HeyPCB/iris-brainstem/media/bottom.png

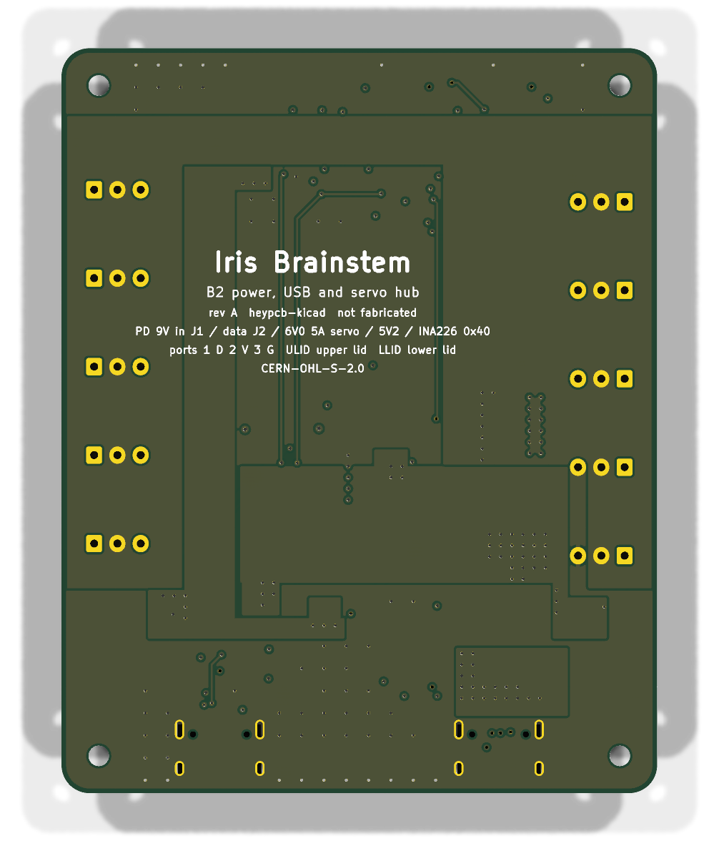
media/bottom.png
