HeyPCB/iris-brainstem/media/top.png

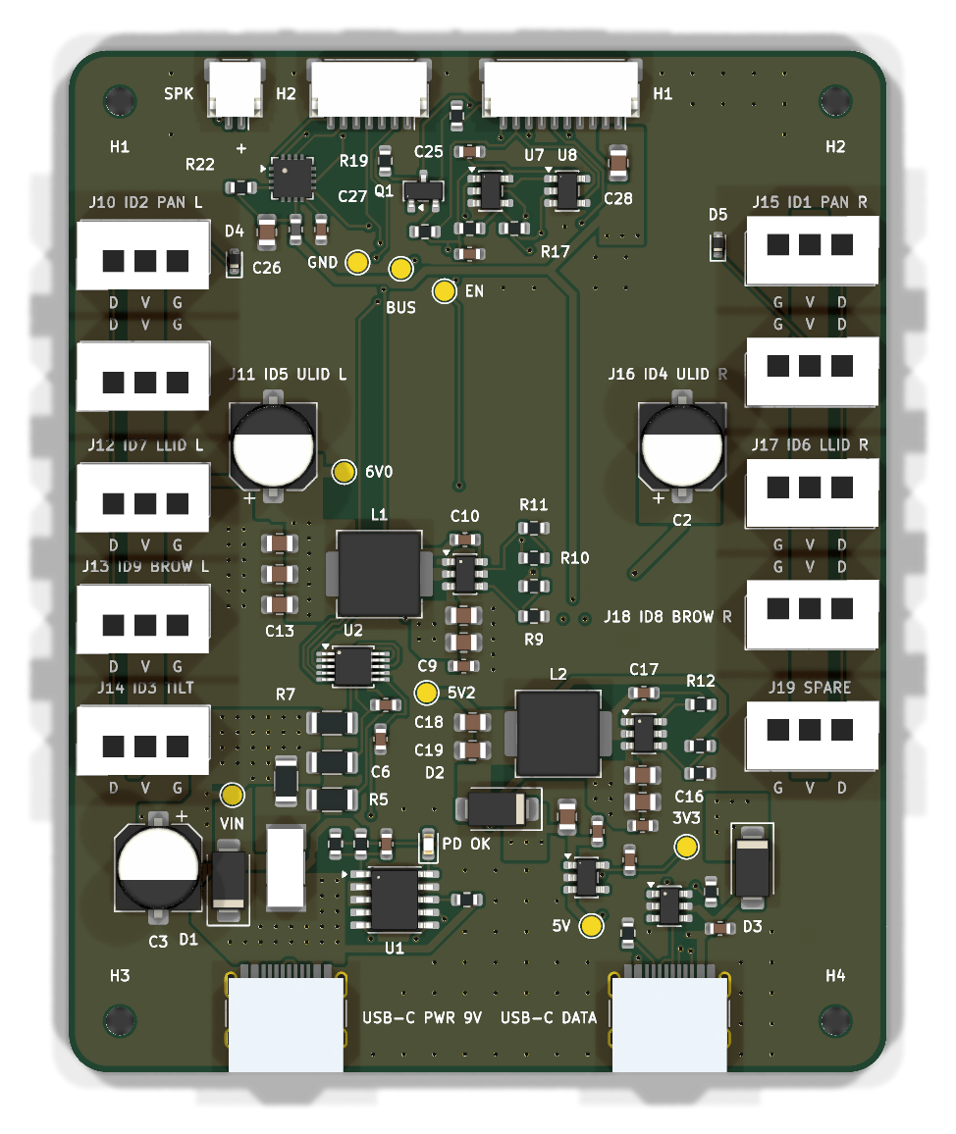
media/top.png
