HeyPCB/iris-brainstem/fab/iris_brainstem_bom.csv

Reference | Value | Footprint | MPN | LCSC | Qty
C1,C2,C3 | 470uF 16V | Capacitor_SMD:CP_Elec_6.3x7.7 | RVT1C471M0607 | C2977552 | 3
C4,C21,C22,C23 | 1uF | Capacitor_SMD:C_0603_1608Metric | CL10A105KB8NNNC | C15849 | 4
C5,C6,C9,C10,C16,C17,C24,C25,C27 | 100nF | Capacitor_SMD:C_0603_1608Metric | CC0603KRX7R9BB104 | C14663 | 9
C7,C8,C14,C15,C26,C28 | 10uF | Capacitor_SMD:C_0805_2012Metric | CL21A106KAYNNNE | C15850 | 6
C11,C12,C13,C18,C19,C20 | 22uF | Capacitor_SMD:C_0805_2012Metric | CL21A226MAQNNNE | C45783 | 6
D1 | SMAJ15A | Diode_SMD:D_SMA | SMAJ15A | C19077535 | 1
D2,D3 | SS34 | Diode_SMD:D_SMA | SS34 | C8678 | 2
D4,D5 | ESD5Z5.0 | Diode_SMD:D_SOD-523 | ESD5Z5.0T1G | C82044 | 2
D6 | Red (PD OK) | LED_SMD:LED_0603_1608Metric | KT-0603R | C2286 | 1
F1 | 5A | Fuse:Fuse_Littelfuse-NANO2-451_453 | 0451005.MRL | C48467 | 1
FB1 | 120R@100MHz | Inductor_SMD:L_0603_1608Metric | BLM18PG121SN1D | C14709 | 1
J1 | USB-C PWR | Connector_USB:USB_C_Receptacle_HRO_TYPE-C-31-M-12 | TYPE-C-31-M-12 | C165948 | 1
J2 | USB-C DATA | Connector_USB:USB_C_Receptacle_HRO_TYPE-C-31-M-12 | TYPE-C-31-M-12 | C165948 | 1
J5 | H1 | Connector_JST:JST_SH_SM10B-SRSS-TB_1x10-1MP_P1.00mm_Horizontal | SM10B-SRSS-TB(LF)(SN) | C160409 | 1
J6 | H2 | Connector_JST:JST_SH_SM07B-SRSS-TB_1x07-1MP_P1.00mm_Horizontal | SM07B-SRSS-TB(LF)(SN) | C160406 | 1
J7 | SPK | Connector_JST:JST_SH_SM02B-SRSS-TB_1x02-1MP_P1.00mm_Horizontal | SM02B-SRSS-TB(LF)(SN) | C160402 | 1
J10,J11,J12,J13,J14,J15,J16,J17,J18,J19 | SERVO | Connector_Molex:Molex_SPOX_5267-03A_1x03_P2.50mm_Vertical | HC-5264-3A | C2845815 | 10
L1 | 3.3uH | Inductor_SMD:L_Changjiang_FXL0630 | FXL0630-3R3-M | C167219 | 1
L2 | 5.6uH | Inductor_SMD:L_Changjiang_FXL0630 | FXL0630-5R6-M | C475914 | 1
Q1 | MMBT3906 | Package_TO_SOT_SMD:SOT-23 | MMBT3906LT1G | C53444 | 1
R1 | 10m | Resistor_SMD:R_1206_3216Metric | FMF06FTHR010-LH | C105362 | 1
R2,R10 | 1k | Resistor_SMD:R_0603_1608Metric | 0603WAF1001T5E | C21190 | 2
R3,R9,R14,R17,R18,R20,R21 | 10k | Resistor_SMD:R_0603_1608Metric | FRC0603F1002TS | C2906982 | 7
R4 | 2.2k | Resistor_SMD:R_0603_1608Metric | 0603WAF2201T5E | C4190 | 1
R5,R6,R7 | 10 | Resistor_SMD:R_1206_3216Metric | 1206W4F100JT5E | C17903 | 3
R8 | 68k | Resistor_SMD:R_0603_1608Metric | 0603WAF6802T5E | C23231 | 1
R11 | 100k | Resistor_SMD:R_0603_1608Metric | 0603WAF1003T5E | C25803 | 1
R12 | 33 | Resistor_SMD:R_0603_1608Metric | 0603WAF330JT5E | C23140 | 1
R13 | 54.9k | Resistor_SMD:R_0603_1608Metric | 0603WAF5492T5E | C23077 | 1
R15,R16 | 5.1k | Resistor_SMD:R_0603_1608Metric | 0603WAF5101T5E | C23186 | 2
R19 | 20k | Resistor_SMD:R_0603_1608Metric | 0603WAF2002T5E | C4184 | 1
R22 | 1M | Resistor_SMD:R_0603_1608Metric | 0603WAF1004T5E | C22935 | 1
U1 | CH224K | Package_SO:SSOP-10-1EP_3.9x4.9mm_P1mm_EP2.1x3.3mm | CH224K | C970725 | 1
U2 | INA226 | Package_SO:TSSOP-10_3x3mm_P0.5mm | INA226AIDGSR | C49851 | 1
U3 | TPS565208 | Package_TO_SOT_SMD:SOT-23-6 | TPS565208DDCR | C2650336 | 1
U4 | TPS56339 | Package_TO_SOT_SMD:SOT-23-6 | TPS56339DDCR | C2071106 | 1
U5 | USBLC6-2SC6 | Package_TO_SOT_SMD:SOT-23-6 | USBLC6-2SC6 | C7519 | 1
U6 | AP2112K-3.3 | Package_TO_SOT_SMD:SOT-23-5 | AP2112K-3.3TRG1 | C51118 | 1
U7 | 74LVC1G126 | Package_TO_SOT_SMD:SOT-23-5 | SN74LVC1G126DBVR | C7834 | 1
U8 | 74LVC1G125 | Package_TO_SOT_SMD:SOT-23-5 | SN74LVC1G125DBVR | C23654 | 1
U9 | MAX98357A | Package_DFN_QFN:TQFN-16-1EP_3x3mm_P0.5mm_EP1.23x1.23mm | MAX98357AETE+T | C910544 | 1
