HeyPCB/iris-brainstem/fab/iris_brainstem.step

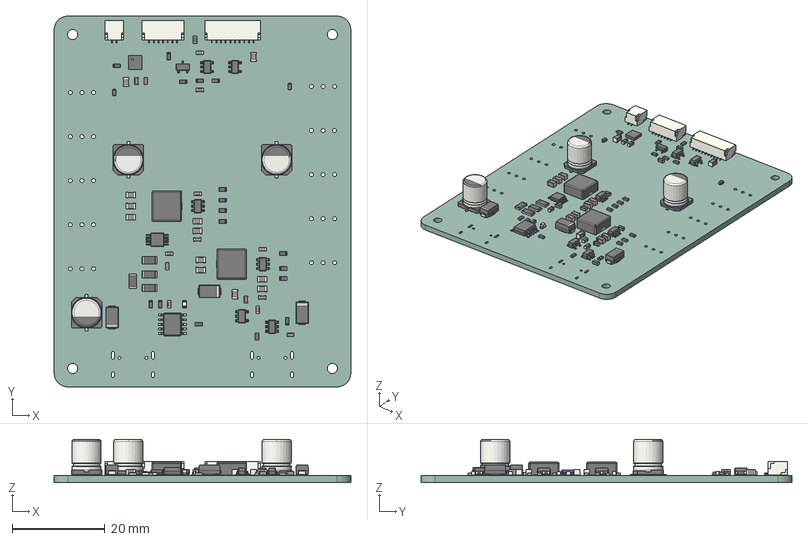
[picture p5: CAD file, 2026-10-03]
fab/iris_brainstem.step
64.0 x 80.0 x 9.29 mm
SSOP-10-1EP_3.9x4.9mm_P1mm_EP2.1x3.3mm
C_0603_1608Metric x 13
R_0603_1608Metric x 18
C_0805_2012Metric x 12
SOT-23-6 x 3
CP_Elec_63x77 x 3
D_SMA x 3
LED_0603_1608Metric
SOT-23-5 x 3
SOT-23
JST_SH_SM02B-SRSS-TB_1x02-1MP_P1.00mm_Horizontal
R_1206_3216Metric x 4
JST_SH_SM07B-SRSS-TB_1x07-1MP_P1.00mm_Horizontal
D_SOD_523 x 2
TQFN_16_1EP_3x3mm_P05mm_EP16x16mm
L_0603_1608Metric
L_Changjiang_FXL0630 x 2
JST_SH_SM10B-SRSS-TB_1x10-1MP_P1.00mm_Horizontal
TSSOP-10_3x3mm_P0.5mm
iris_brainstem_PCB
