HeyPCB/iris-brainstem/fab/iris_brainstem_schematic.pdf

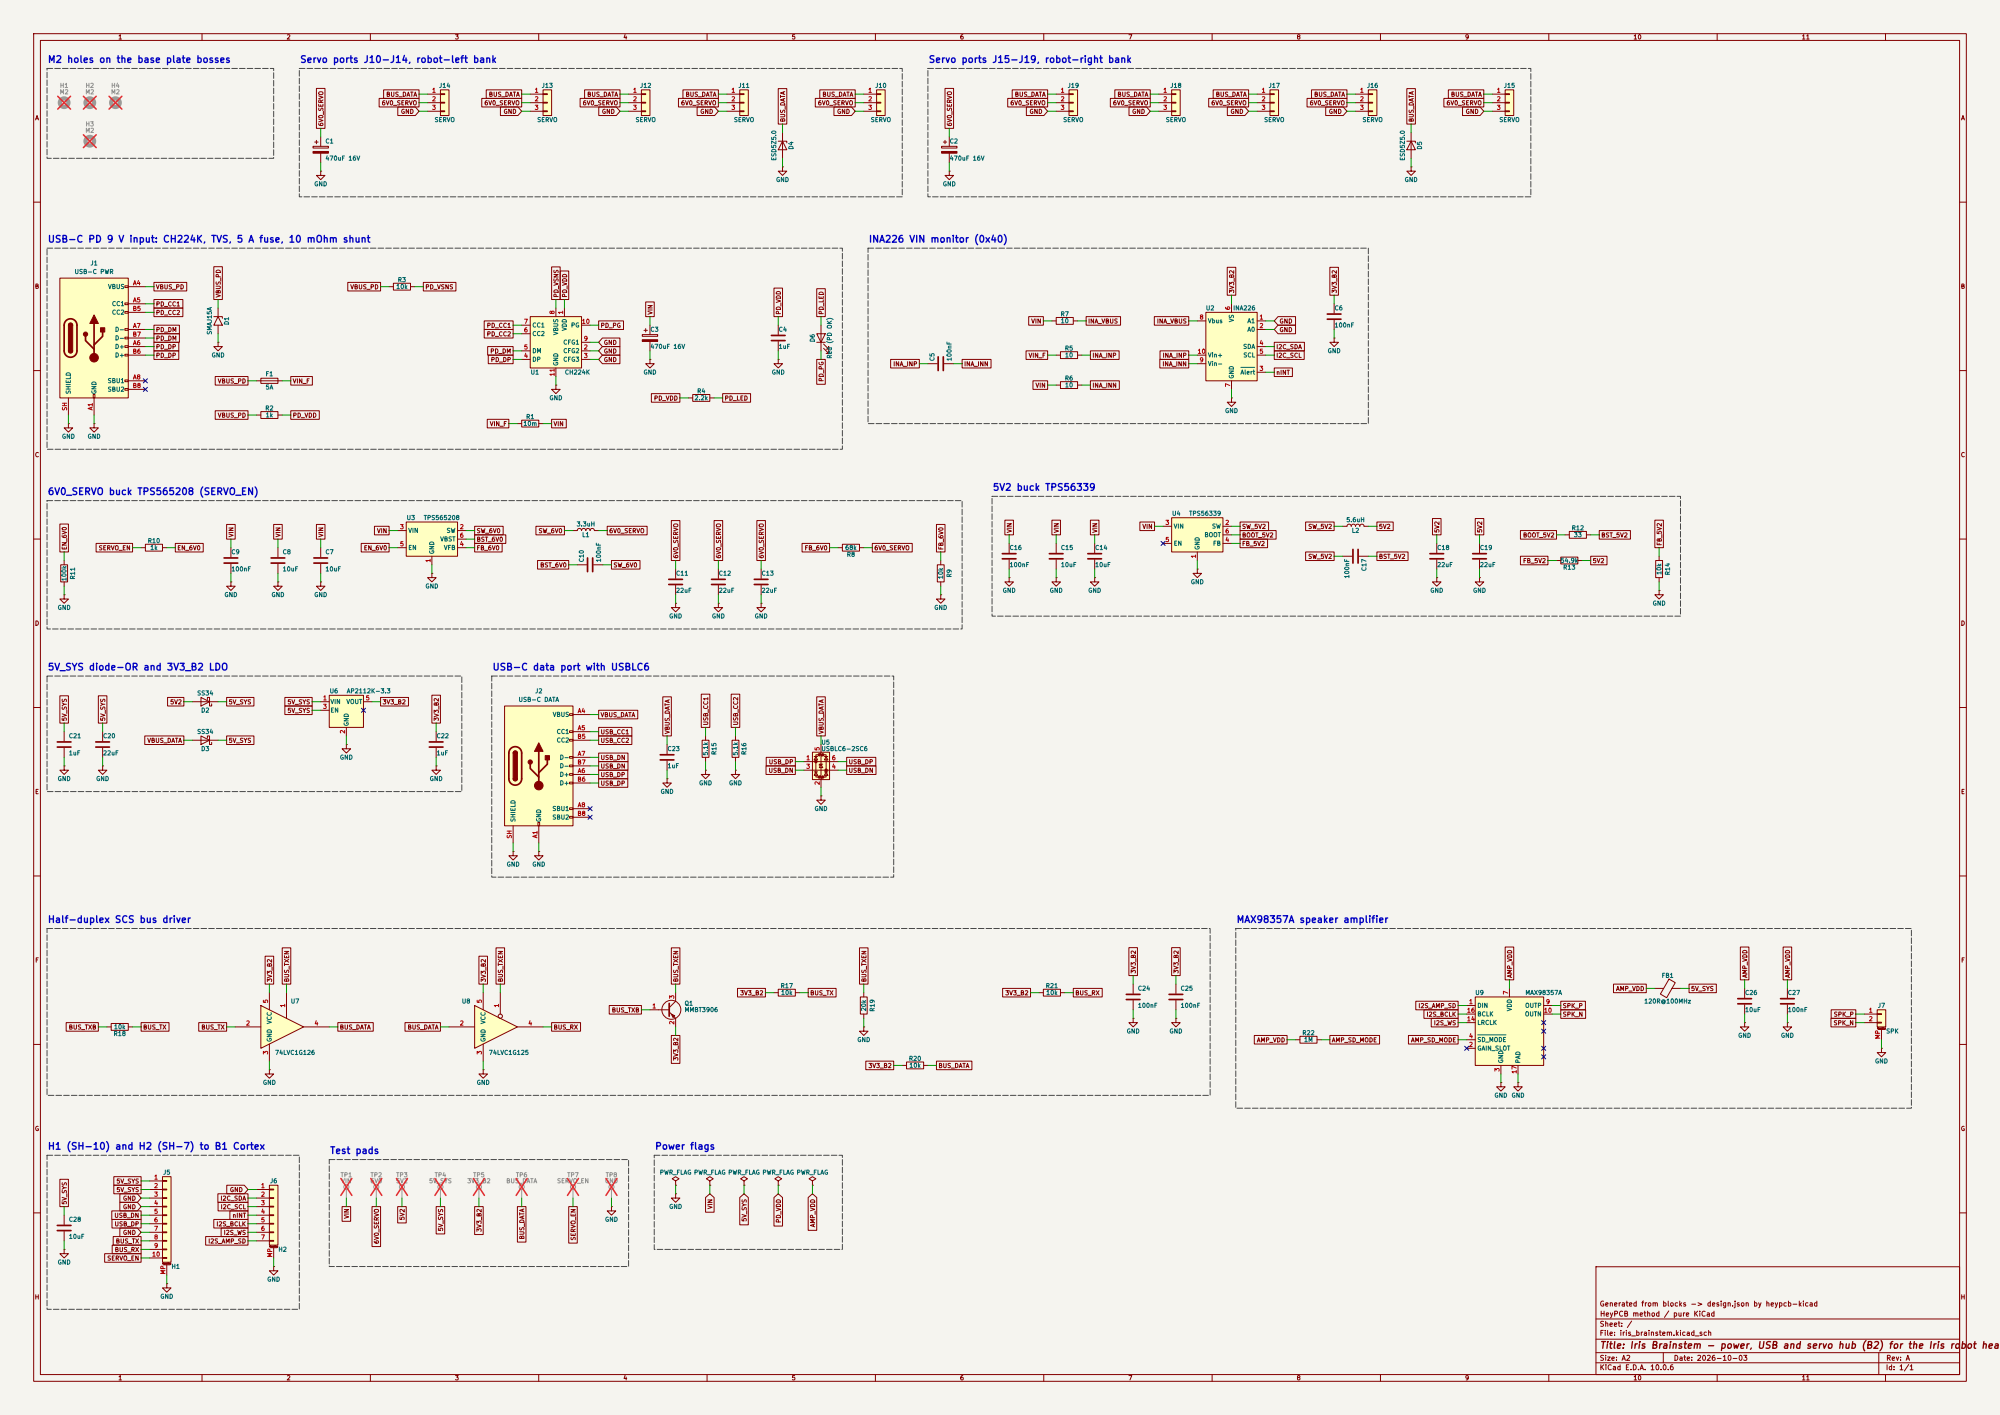
[picture p6: page 1]

M2 holes on the base plate bosses

Servo ports J15-J19, robot-right bank

USB-C PD 9 V input: CH224K, TVS, 5 A fuse, 10 mOhm shunt

5V_SYS diode-OR and 3V3_B2 LDO

USB-C data port with USBLC6

Half-duplex SCS bus driver

H1 (SH-10) and H2 (SH-7) to B1 Cortex

Generated from blocks -> design.json by heypcb-kicad
HeyPCB method / pure KiCad
Sheet: /
File: iris_brainstem.kicad_sch
Title: Iris Brainstem - power, USB and servo hub (B2) for the Iris robot head

Size: A2 | Rev: A
KiCad E.D.A. 10.0.6 | Id: 1/1
