HeyPCB/iris-brainstem/kicad/iris_brainstem.kicad_pcb

## KiCad design kicad/iris_brainstem.kicad_pcb (2026-10-03)

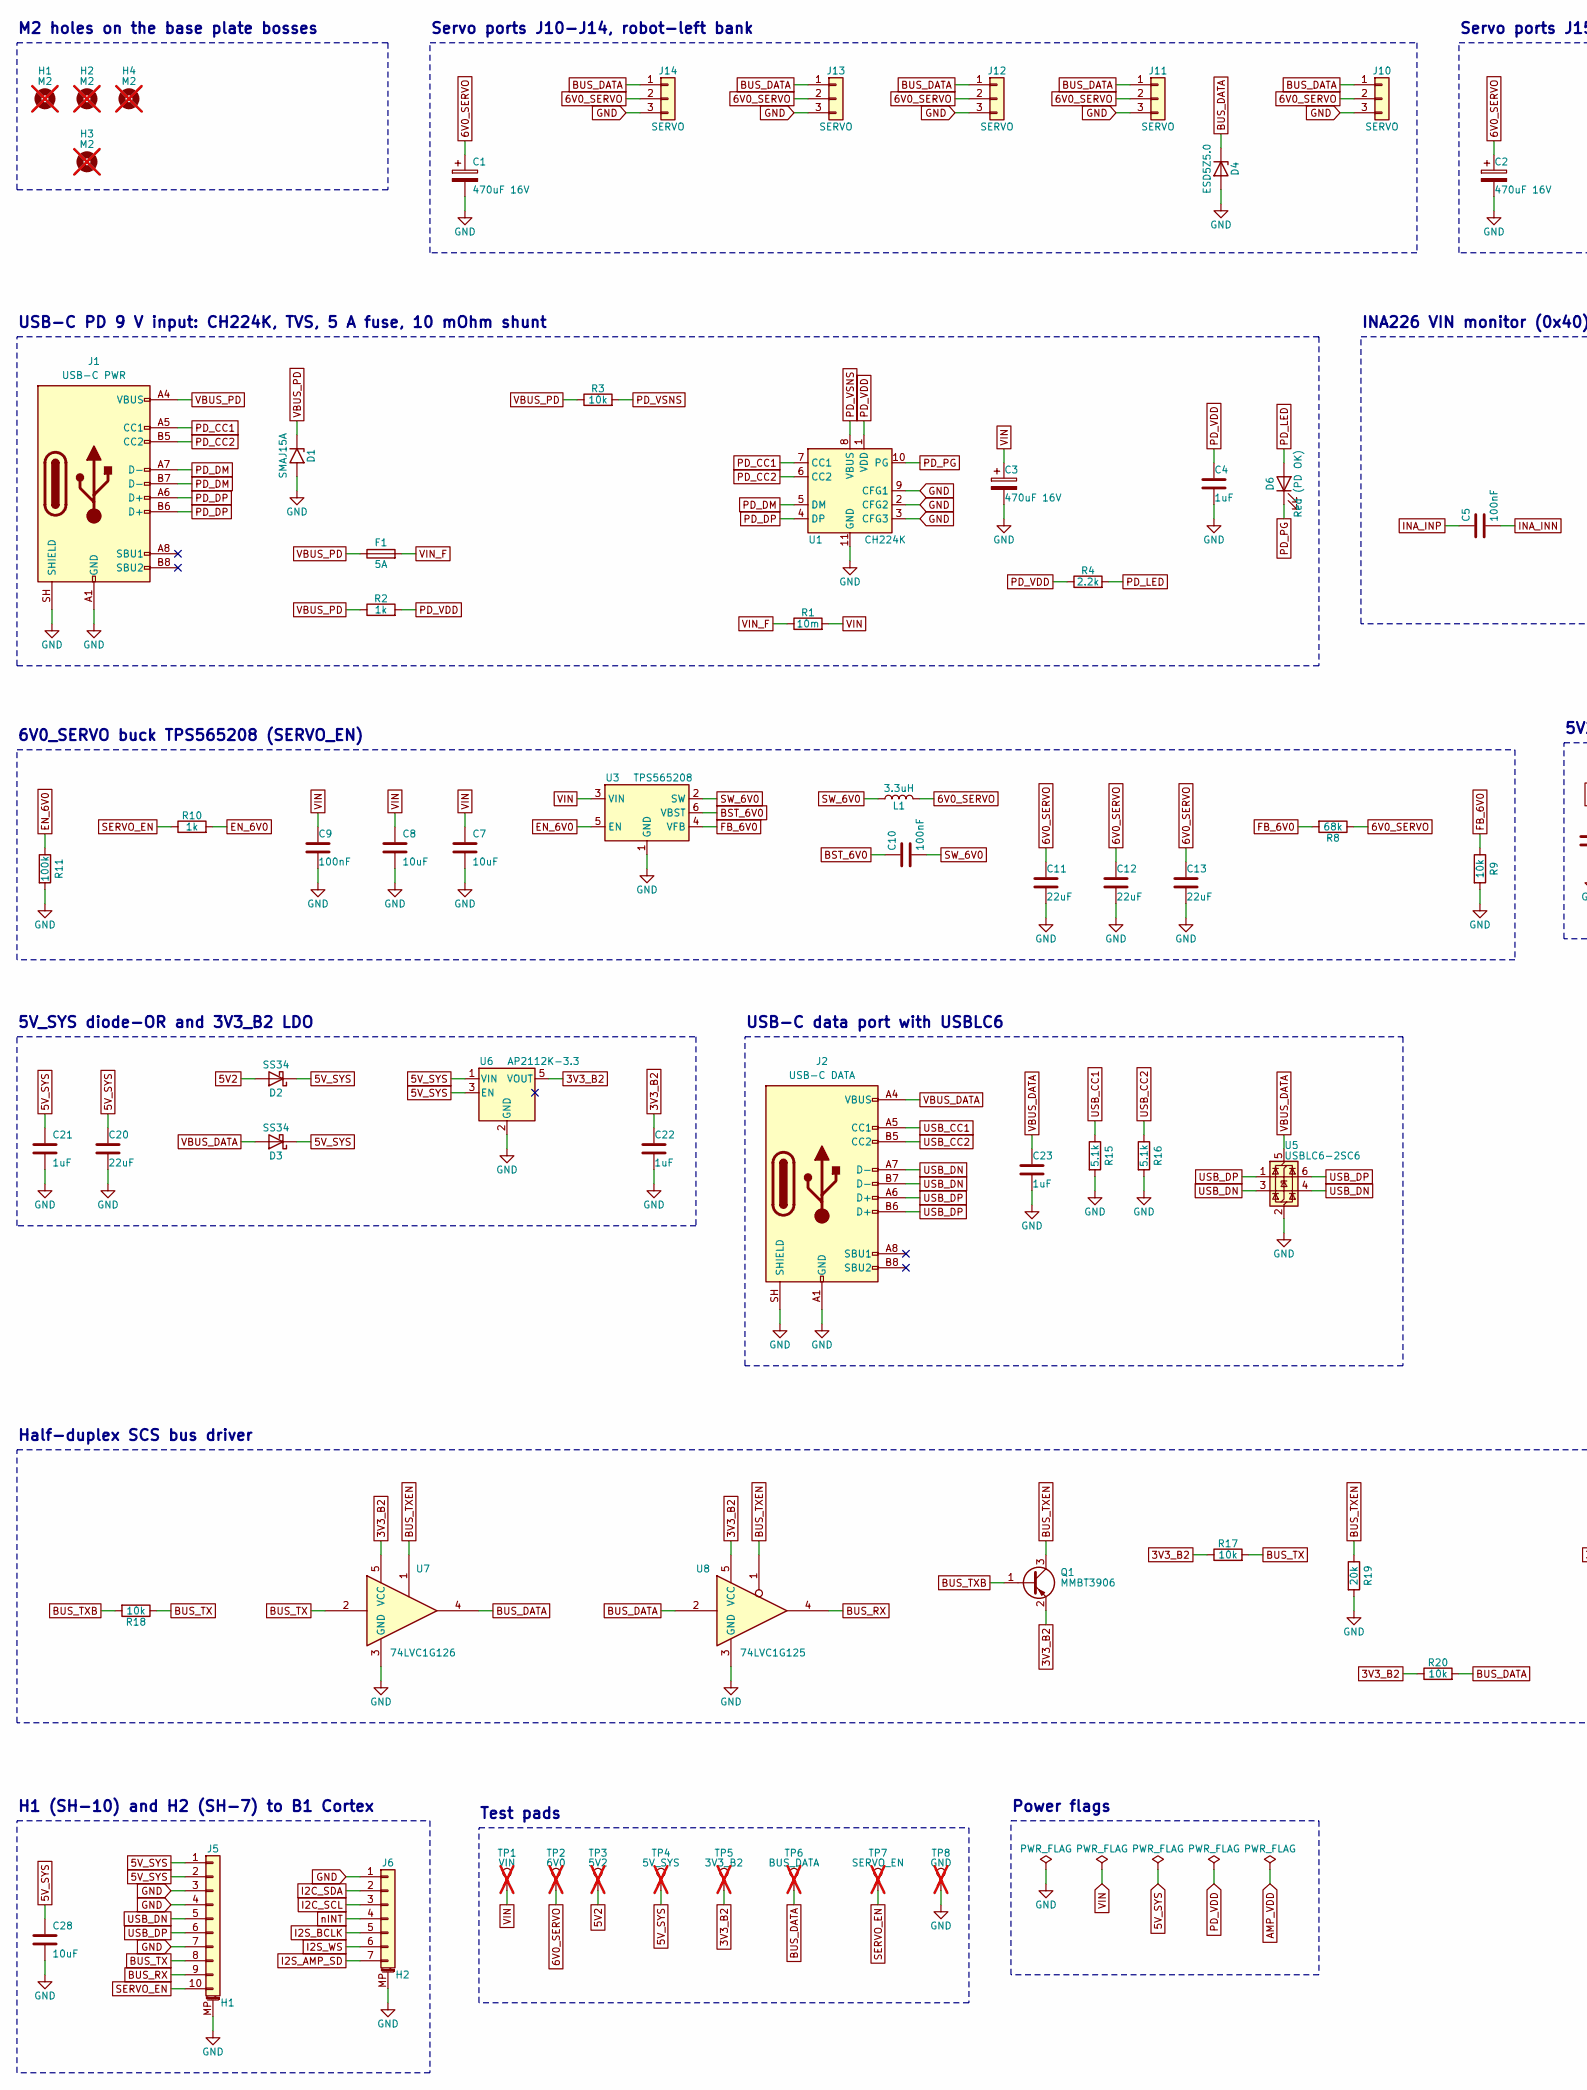
[picture p7: schematic iris_brainstem.kicad_sch, Iris Brainstem - power, USB and servo hub (B2) for the Iris…, part in row 1, column 1]

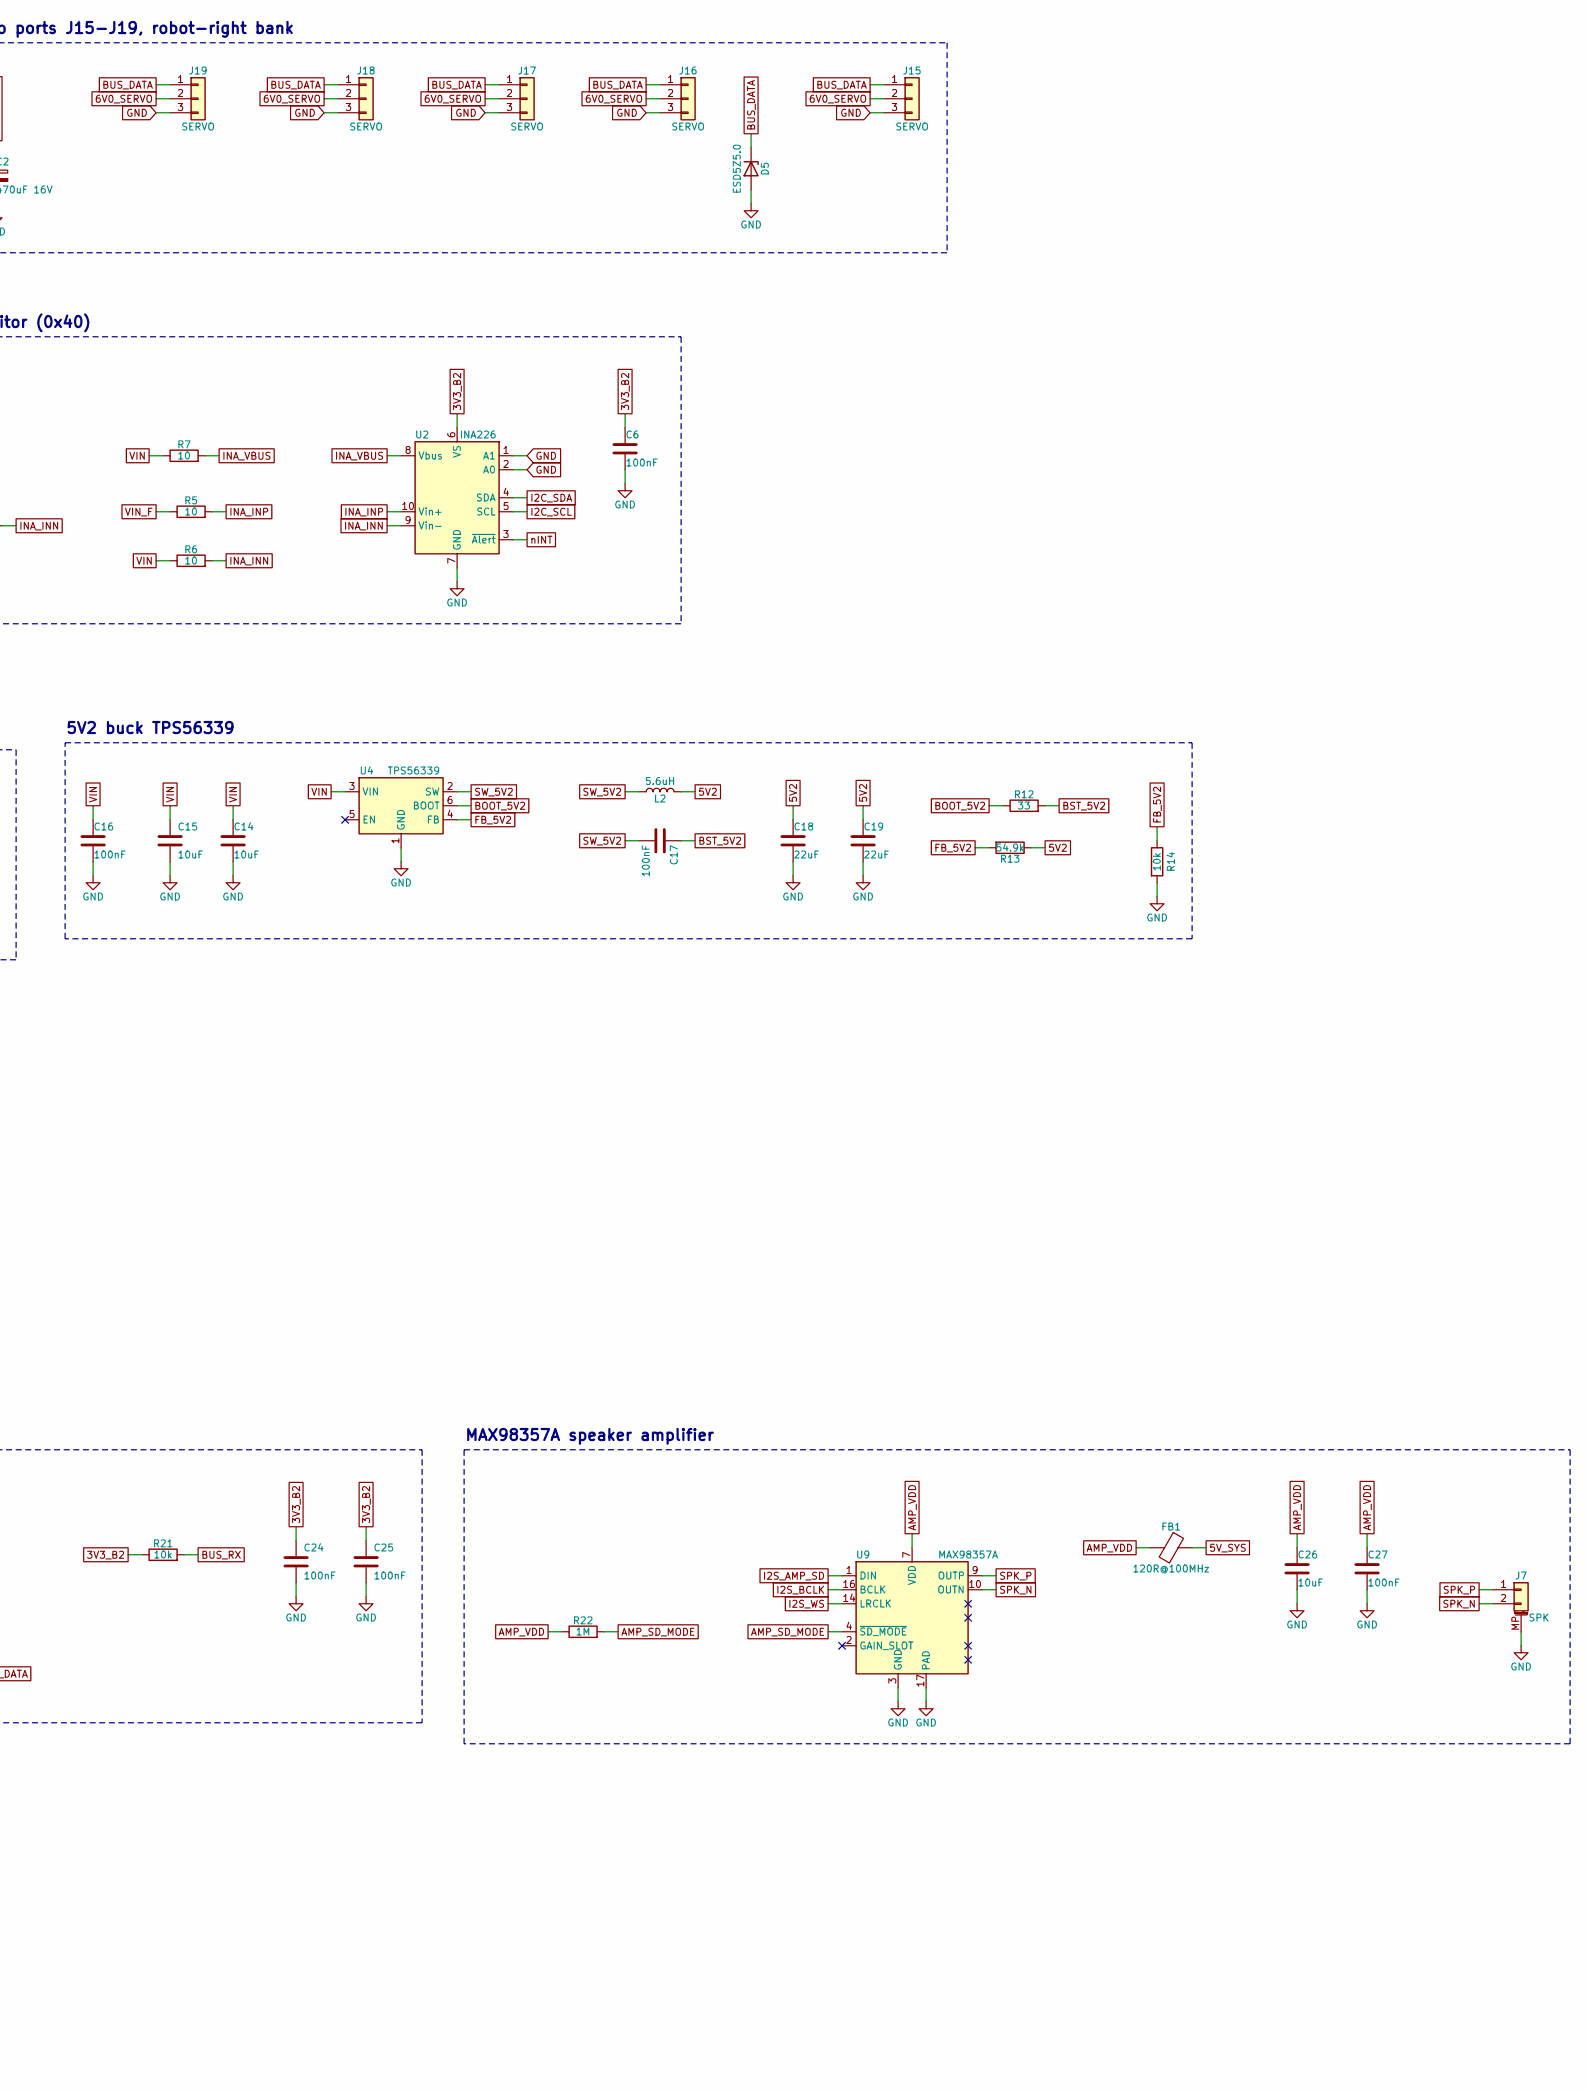
[picture p8: schematic iris_brainstem.kicad_sch, Iris Brainstem - power, USB and servo hub (B2) for the Iris…, part in row 1, column 2]

Parts:
C1, C2, C3: 470uF 16V; CP_Elec_6.3x7.7; MPN RVT1C471M0607; LCSC C2977552
C4, C21, C22, C23: 1uF; C_0603_1608Metric; MPN CL10A105KB8NNNC; LCSC C15849
C5, C6, C9, C10, C16, C17, C24, C25, C27: 100nF; C_0603_1608Metric; MPN CC0603KRX7R9BB104; LCSC C14663
C7, C8, C14, C15, C26, C28: 10uF; C_0805_2012Metric; MPN CL21A106KAYNNNE; LCSC C15850
C11, C12, C13, C18, C19, C20: 22uF; C_0805_2012Metric; MPN CL21A226MAQNNNE; LCSC C45783
D1: SMAJ15A; D_SMA; MPN SMAJ15A; LCSC C19077535
D2, D3: SS34; D_SMA; MPN SS34; LCSC C8678
D4, D5: ESD5Z5.0; D_SOD-523; MPN ESD5Z5.0T1G; LCSC C82044
D6: Red (PD OK); LED_0603_1608Metric; MPN KT-0603R; LCSC C2286
F1: 5A; Fuse_Littelfuse-NANO2-451_453; MPN 0451005.MRL; LCSC C48467
FB1: 120R@100MHz; L_0603_1608Metric; MPN BLM18PG121SN1D; LCSC C14709
H1, H2, H3, H4: M2; MountingHole_2.2mm_M2; not fitted
J1: USB-C PWR; USB_C_Receptacle_HRO_TYPE-C-31-M-12; MPN TYPE-C-31-M-12; LCSC C165948
J2: USB-C DATA; USB_C_Receptacle_HRO_TYPE-C-31-M-12; MPN TYPE-C-31-M-12; LCSC C165948
J5: H1; JST_SH_SM10B-SRSS-TB_1x10-1MP_P1.00mm_Horizontal; MPN SM10B-SRSS-TB(LF)(SN); LCSC C160409
J6: H2; JST_SH_SM07B-SRSS-TB_1x07-1MP_P1.00mm_Horizontal; MPN SM07B-SRSS-TB(LF)(SN); LCSC C160406
J7: SPK; JST_SH_SM02B-SRSS-TB_1x02-1MP_P1.00mm_Horizontal; MPN SM02B-SRSS-TB(LF)(SN); LCSC C160402
J10, J11, J12, J13, J14, J15, J16, J17, J18, J19: SERVO; Molex_SPOX_5267-03A_1x03_P2.50mm_Vertical; MPN HC-5264-3A; LCSC C2845815
L1: 3.3uH; L_Changjiang_FXL0630; MPN FXL0630-3R3-M; LCSC C167219
L2: 5.6uH; L_Changjiang_FXL0630; MPN FXL0630-5R6-M; LCSC C475914
Q1: MMBT3906; SOT-23; MPN MMBT3906LT1G; LCSC C53444
R1: 10m; R_1206_3216Metric; MPN FMF06FTHR010-LH; LCSC C105362
R2, R10: 1k; R_0603_1608Metric; MPN 0603WAF1001T5E; LCSC C21190
R3, R9, R14, R17, R18, R20, R21: 10k; R_0603_1608Metric; MPN FRC0603F1002TS; LCSC C2906982
R4: 2.2k; R_0603_1608Metric; MPN 0603WAF2201T5E; LCSC C4190
R5, R6, R7: 10; R_1206_3216Metric; MPN 1206W4F100JT5E; LCSC C17903
R8: 68k; R_0603_1608Metric; MPN 0603WAF6802T5E; LCSC C23231
R11: 100k; R_0603_1608Metric; MPN 0603WAF1003T5E; LCSC C25803
R12: 33; R_0603_1608Metric; MPN 0603WAF330JT5E; LCSC C23140
R13: 54.9k; R_0603_1608Metric; MPN 0603WAF5492T5E; LCSC C23077
R15, R16: 5.1k; R_0603_1608Metric; MPN 0603WAF5101T5E; LCSC C23186
R19: 20k; R_0603_1608Metric; MPN 0603WAF2002T5E; LCSC C4184
R22: 1M; R_0603_1608Metric; MPN 0603WAF1004T5E; LCSC C22935
TP1: VIN; TestPoint_Pad_D1.5mm; not fitted
TP2: 6V0; TestPoint_Pad_D1.5mm; not fitted
TP3: 5V2; TestPoint_Pad_D1.5mm; not fitted
TP4: 5V_SYS; TestPoint_Pad_D1.5mm; not fitted
TP5: 3V3_B2; TestPoint_Pad_D1.5mm; not fitted
TP6: BUS_DATA; TestPoint_Pad_D1.5mm; not fitted
TP7: SERVO_EN; TestPoint_Pad_D1.5mm; not fitted
TP8: GND; TestPoint_Pad_D1.5mm; not fitted
U1: CH224K; SSOP-10-1EP_3.9x4.9mm_P1mm_EP2.1x3.3mm; MPN CH224K; LCSC C970725
U2: INA226; TSSOP-10_3x3mm_P0.5mm; MPN INA226AIDGSR; LCSC C49851
U3: TPS565208; SOT-23-6; MPN TPS565208DDCR; LCSC C2650336
U4: TPS56339; SOT-23-6; MPN TPS56339DDCR; LCSC C2071106
U5: USBLC6-2SC6; SOT-23-6; MPN USBLC6-2SC6; LCSC C7519
U6: AP2112K-3.3; SOT-23-5; MPN AP2112K-3.3TRG1; LCSC C51118
U7: 74LVC1G126; SOT-23-5; MPN SN74LVC1G126DBVR; LCSC C7834
U8: 74LVC1G125; SOT-23-5; MPN SN74LVC1G125DBVR; LCSC C23654
U9: MAX98357A; TQFN-16-1EP_3x3mm_P0.5mm_EP1.23x1.23mm; MPN MAX98357AETE+T; LCSC C910544

Connections:
3V3_B2: C6.1, C22.1, C24.1, C25.1, Q1.2 (E), R17.1, R20.1, R21.1, TP5.1, U2.6 (VS), U6.5 (VOUT), U7.5 (VCC), U8.5 (VCC)
5V2: C18.1, C19.1, D2.2 (A), L2.2, R13.1, TP3.1
5V_SYS: C20.1, C21.1, C28.1, D2.1 (K), D3.1 (K), FB1.1, J5.1, J5.2, TP4.1, U6.1 (VIN), U6.3 (EN)
6V0_SERVO: C1.1, C2.1, C11.1, C12.1, C13.1, J10.2, J11.2, J12.2, J13.2, J14.2, J15.2, J16.2, J17.2, J18.2, J19.2, L1.2, R8.1, TP2.1
AMP_SD_MODE: R22.2, U9.4 (~SD_MODE)
AMP_VDD: C26.1, C27.1, FB1.2, R22.1, U9.7 (VDD), U9.8 (VDD)
BOOT_5V2: R12.1, U4.6 (BOOT)
BST_5V2: C17.1, R12.2
BST_6V0: C10.1, U3.6 (VBST)
BUS_DATA: D4.1 (K), D5.1 (K), J10.1, J11.1, J12.1, J13.1, J14.1, J15.1, J16.1, J17.1, J18.1, J19.1, R20.2, TP6.1, U7.4, U8.2
BUS_RX: J5.9, R21.2, U8.4
BUS_TX: J5.8, R17.2, R18.1, U7.2
BUS_TXB: Q1.1 (B), R18.2
BUS_TXEN: Q1.3 (C), R19.1, U7.1, U8.1
EN_6V0: R10.2, R11.1, U3.5 (EN)
FB_5V2: R13.2, R14.1, U4.4 (FB)
FB_6V0: R8.2, R9.1, U3.4 (VFB)
GND: C1.2, C2.2, C3.2, C4.2, C6.2, C7.2, C8.2, C9.2, C11.2, C12.2, C13.2, C14.2, C15.2, C16.2, C18.2, C19.2, C20.2, C21.2, C22.2, C23.2, C24.2, C25.2, C26.2, C27.2, C28.2, D1.2 (A2), D4.2 (A), D5.2 (A), J1.A1 (GND), J1.A12 (GND), J1.B1 (GND), J1.B12 (GND), J1.SH (SHIELD), J2.A1 (GND), J2.A12 (GND), J2.B1 (GND), J2.B12 (GND), J2.SH (SHIELD), J5.3, J5.4, J5.7, J5.MP (MountPin), J6.1, J6.MP (MountPin), J7.MP (MountPin), J10.3, J11.3, J12.3, J13.3, J14.3, J15.3, J16.3, J17.3, J18.3, J19.3, R9.2, R11.2, R14.2, R15.2, R16.2, R19.2, TP8.1, U1.2 (CFG2), U1.3 (CFG3), U1.9 (CFG1), U1.11 (GND), U2.1 (A1), U2.2 (A0), U2.7 (GND), U3.1 (GND), U4.1 (GND), U5.2 (GND), U6.2 (GND), U7.3 (GND), U8.3 (GND), U9.3 (GND), U9.11 (GND), U9.15 (GND), U9.17 (PAD)
I2C_SCL: J6.3, U2.5 (SCL)
I2C_SDA: J6.2, U2.4 (SDA)
I2S_AMP_SD: J6.7, U9.1 (DIN)
I2S_BCLK: J6.5, U9.16 (BCLK)
I2S_WS: J6.6, U9.14 (LRCLK)
INA_INN: C5.2, R6.2, U2.9 (Vin-)
INA_INP: C5.1, R5.2, U2.10 (Vin+)
INA_VBUS: R7.2, U2.8 (Vbus)
PD_CC1: J1.A5 (CC1), U1.7 (CC1)
PD_CC2: J1.B5 (CC2), U1.6 (CC2)
PD_DM: J1.A7 (D-), J1.B7 (D-), U1.5 (DM)
PD_DP: J1.A6 (D+), J1.B6 (D+), U1.4 (DP)
PD_LED: D6.2 (A), R4.2
PD_PG: D6.1 (K), U1.10 (PG)
PD_VDD: C4.1, R2.2, R4.1, U1.1 (VDD)
PD_VSNS: R3.2, U1.8 (VBUS)
SERVO_EN: J5.10, R10.1, TP7.1
SPK_N: J7.2, U9.10 (OUTN)
SPK_P: J7.1, U9.9 (OUTP)
SW_5V2: C17.2, L2.1, U4.2 (SW)
SW_6V0: C10.2, L1.1, U3.2 (SW)
USB_CC1: J2.A5 (CC1), R15.1
USB_CC2: J2.B5 (CC2), R16.1
USB_DN: J2.A7 (D-), J2.B7 (D-), J5.5, U5.3 (I/O2), U5.4 (I/O2)
USB_DP: J2.A6 (D+), J2.B6 (D+), J5.6, U5.1 (I/O1), U5.6 (I/O1)
VBUS_DATA: C23.1, D3.2 (A), J2.A4 (VBUS), J2.A9 (VBUS), J2.B4 (VBUS), J2.B9 (VBUS), U5.5 (VBUS)
VBUS_PD: D1.1 (A1), F1.1, J1.A4 (VBUS), J1.A9 (VBUS), J1.B4 (VBUS), J1.B9 (VBUS), R2.1, R3.1
VIN: C3.1, C7.1, C8.1, C9.1, C14.1, C15.1, C16.1, R1.2, R6.1, R7.1, TP1.1, U3.3 (VIN), U4.3 (VIN)
VIN_F: F1.2, R1.1, R5.1
nINT: J6.4, U2.3 (~Alert)

Notes on the sheet:
M2 holes on the base plate bosses
Servo ports J10-J14, robot-left bank
Servo ports J15-J19, robot-right bank
USB-C PD 9 V input: CH224K, TVS, 5 A fuse, 10 mOhm shunt
INA226 VIN monitor (0x40)
6V0_SERVO buck TPS565208 (SERVO_EN)
5V2 buck TPS56339
5V_SYS diode-OR and 3V3_B2 LDO
USB-C data port with USBLC6
Half-duplex SCS bus driver
MAX98357A speaker amplifier
H1 (SH-10) and H2 (SH-7) to B1 Cortex
Test pads
Power flags

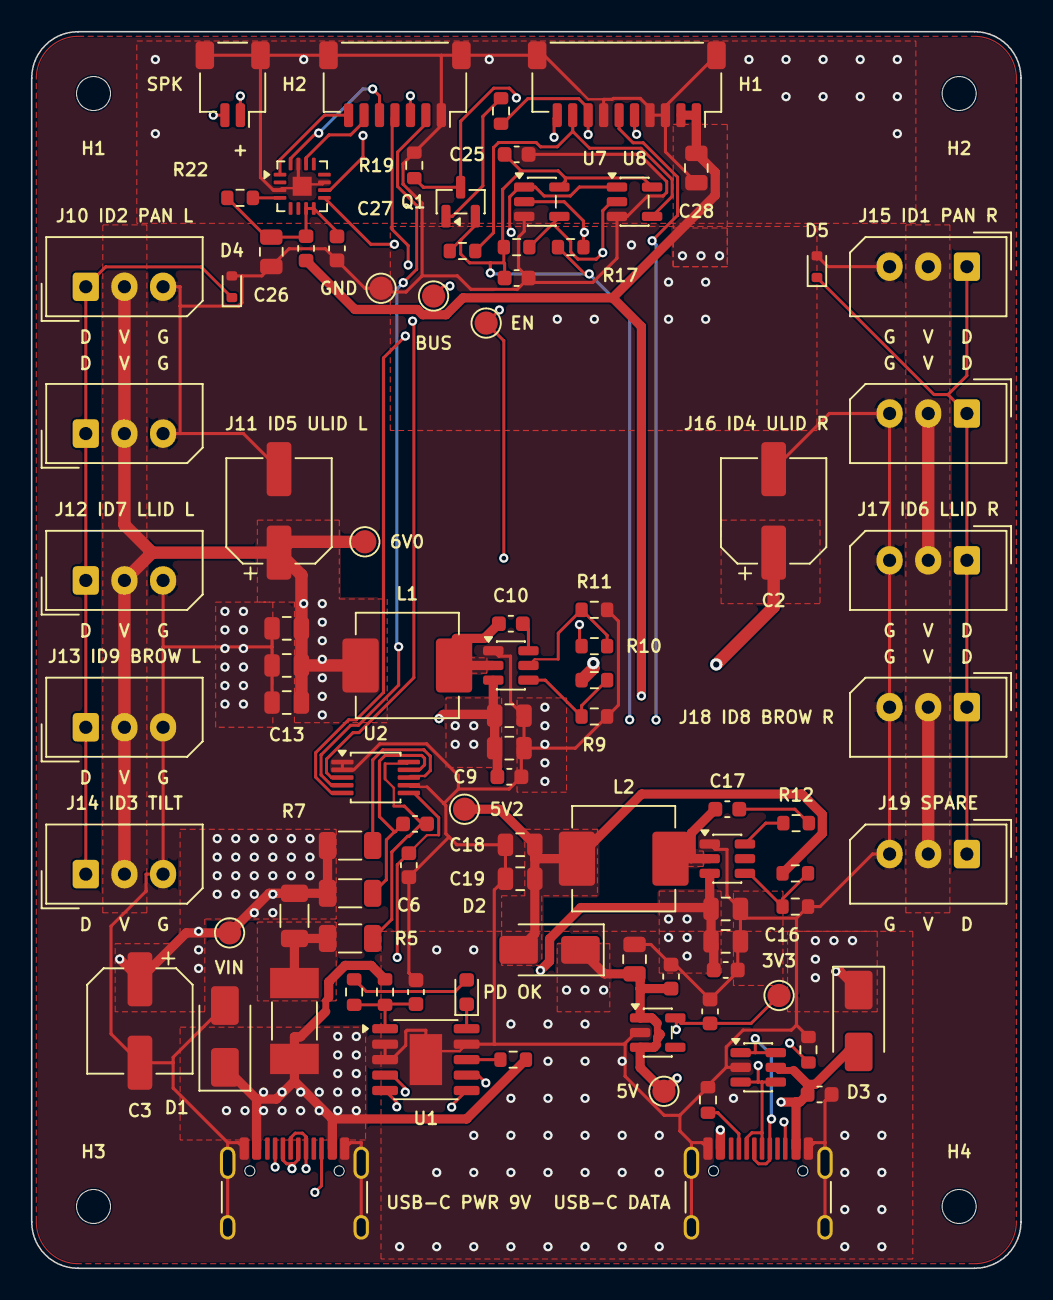
[picture p9: board iris_brainstem.kicad_pcb from above]

Board: 4 copper layers, 64.0 x 80.0 mm, 97 parts (0 on the bottom side), 48 nets.
